Xtriker/Modular_Board/Documentation/Curva de calibracion pasos vs milimetros.ods

Pulley teeth | Belt spech [mm] | Motor angle [°] | Driver microstepping | Motor complete angle | Step per millimeter
30 | 2 | 1.8 | 1 | 200.00 | 3.3
30 | 2 | 1.8 | 2 | 200.00 | 6.7
30 | 2 | 1.8 | 4 | 200.00 | 13.3
30 | 2 | 1.8 | 16 | 200.00 | 53.3
Step per millimeter | Millimeter [mm] | Pulsos a dar
3.3 | 1 | 3
6.6 | 2 | 7
9.9 | 3 | 10
13.2 | 4 | 13
16.5 | 5 | 17
19.8 | 6 | 20
23.1 | 7 | 23
26.4 | 8 | 26
29.7 | 9 | 30
33 | 10 | 33
36.3 | 11 | 36
39.6 | 12 | 40
42.9 | 13 | 43
46.2 | 14 | 46
49.5 | 15 | 50
52.8 | 16 | 53
56.1 | 17 | 56
59.4 | 18 | 59
62.7 | 19 | 63
66 | 20 | 66
69.3 | 21 | 69
72.6 | 22 | 73
75.9 | 23 | 76
79.2 | 24 | 79
82.5 | 25 | 83
85.8 | 26 | 86
89.1 | 27 | 89
92.4 | 28 | 92
95.7 | 29 | 96
99 | 30 | 99
102.3 | 31 | 102
105.6 | 32 | 106
108.9 | 33 | 109
112.2 | 34 | 112
115.5 | 35 | 116
118.8 | 36 | 119
122.1 | 37 | 122
125.4 | 38 | 125
128.7 | 39 | 129
132 | 40 | 132
135.3 | 41 | 135
138.6 | 42 | 139
141.9 | 43 | 142
145.2 | 44 | 145
148.5 | 45 | 149
151.8 | 46 | 152
155.1 | 47 | 155
158.4 | 48 | 158
161.7 | 49 | 162
165 | 50 | 165
168.3 | 51 | 168
171.6 | 52 | 172
174.9 | 53 | 175
178.2 | 54 | 178
181.5 | 55 | 182
184.8 | 56 | 185
188.1 | 57 | 188
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
