Xtriker/Modular_Board/Documentation/Curva_de_calibracion_mm_por_paso.ods

Pulsos | Distancia (cm) | Tiempo (ms) | Frecuencia (Hz) | Microstepping
70 | 1 | 500 | 2 | Full
140 | 2.3 | 500 | 2 | Full
 | 3 | 500 | 2 | Full
 | 4 | 500 | 2 | Full
 | 5 | 500 | 2 | Full
