Xtriker/Modular_Board/EAGLE/projects/Xtriker_Laser_v2/Xtriker_Laser_v2.brd

## EAGLE design EAGLE/projects/Xtriker_Laser_v2/Xtriker_Laser_v2.brd (2020-05-10)

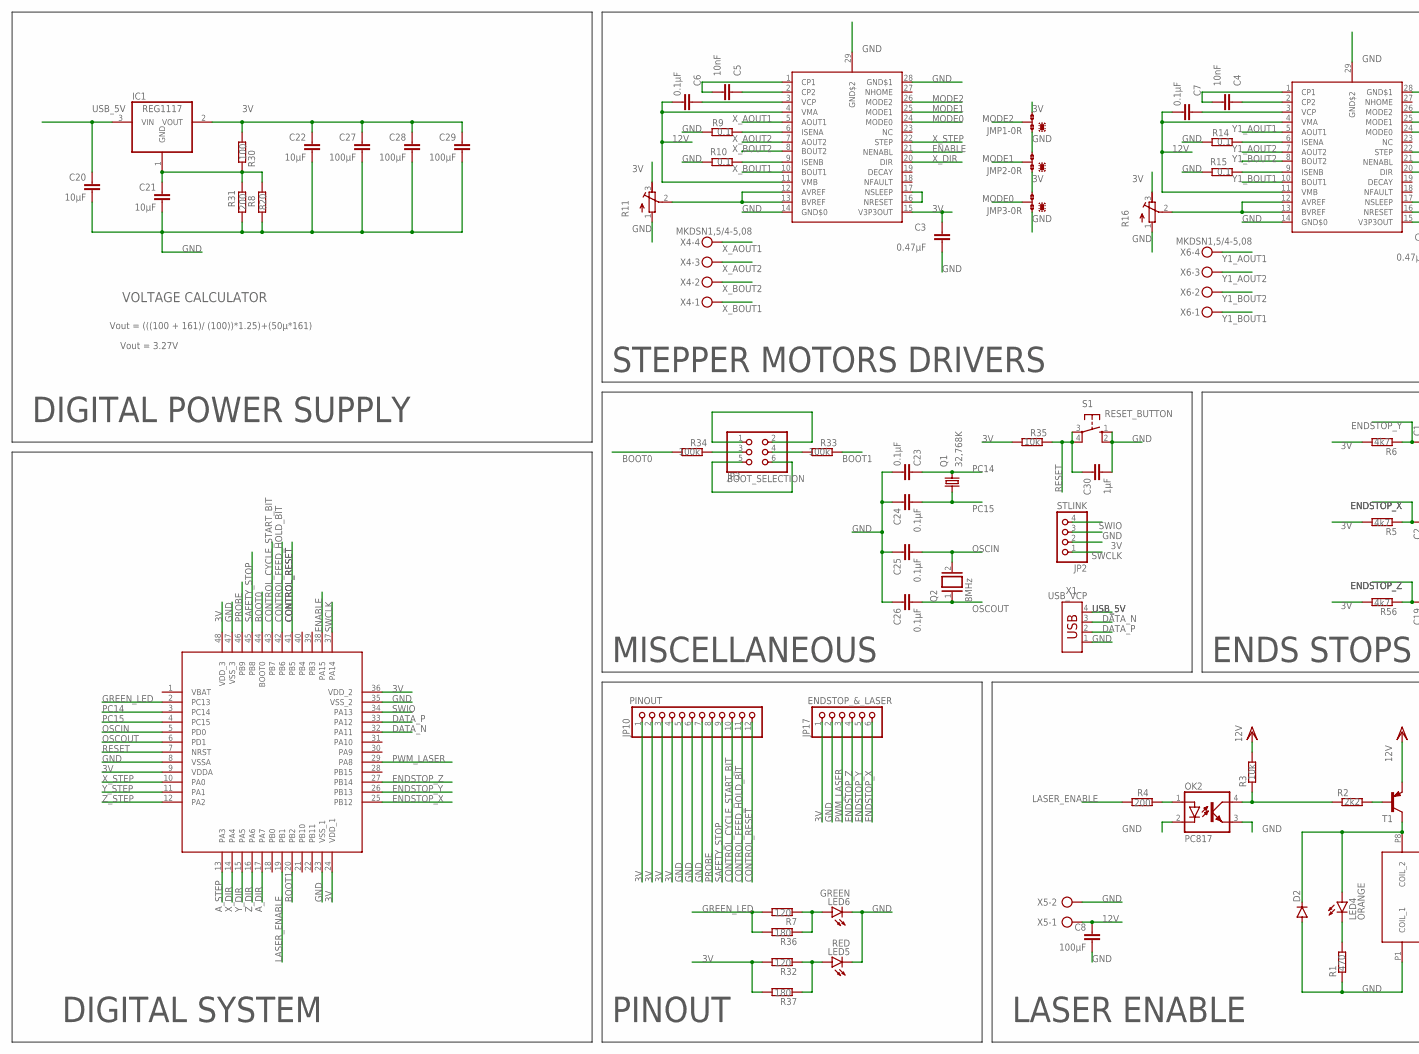
[picture p16: schematic Xtriker_Laser_v2.sch, part in row 1, column 1]

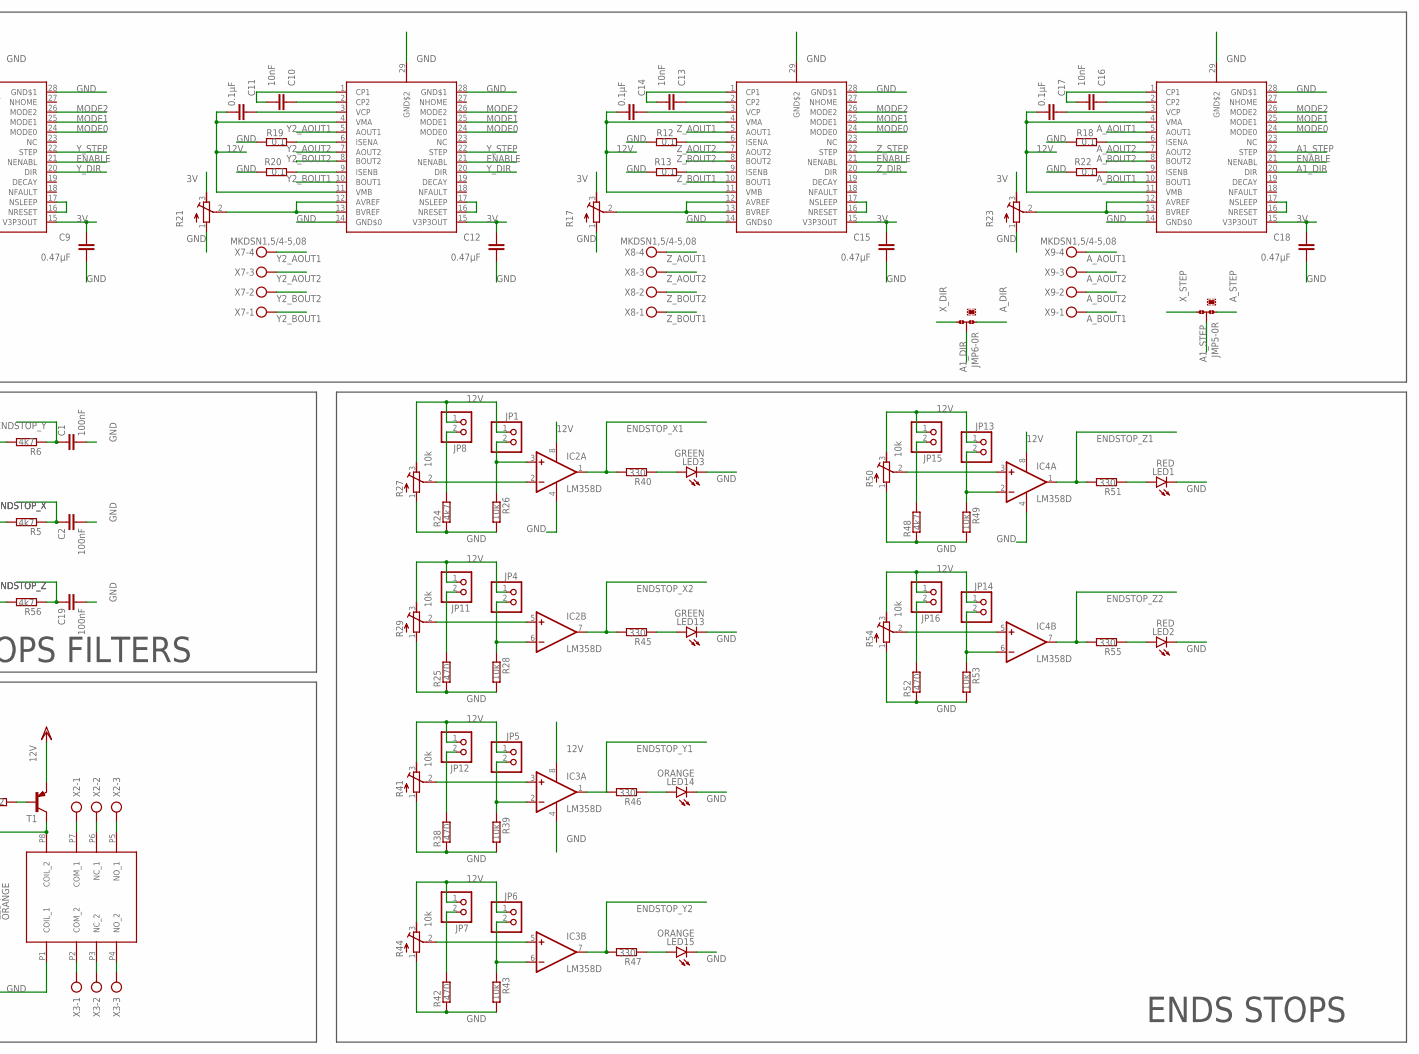
[picture p17: schematic Xtriker_Laser_v2.sch, part in row 1, column 2]

Parts:
C1, C2, C19: 100nF; C0805
C3, C9, C12, C15, C18: 0.47µF; C0805
C4, C5, C10, C13, C16: 10nF; C0805
C6, C7, C11, C14, C17, C23, C24, C25, C26: 0.1µF; C0805
C8, C27, C28, C29: 100µF; C0805
C20, C21, C22: 10µF; C0805
C30: 1µF; C0805
D2: DIODE-DO214AA; DO214AA
IC1: REG1117; SOT223
IC2, IC3, IC4: LM358D; SO08
JMP1, JMP2, JMP3, JMP5, JMP6: 0R-JUMPA; A0R-JMP
JP1, JP4, JP5, JP6, JP7, JP8, JP11, JP12, JP13, JP14, JP15, JP16: PINHD-1X2; 1X02
JP2: STLINK; 1X04
JP3: BOOT_SELECTION; 2X03
JP10: PINOUT; 1X12
JP17: ENDSTOP_&_LASER; 1X06
LED1, LED2, LED5: RED; CHIP-LED0805
LED3, LED6, LED13: GREEN; CHIP-LED0805
LED4, LED14, LED15: ORANGE; CHIP-LED0805
OK2: PC817; DIL04
Q1: 32,768K; 8.2X3.8
Q2: 8MHz; QS
R1, R25, R38, R42, R52: 470; R0805
R2: 2k2; R0805
R3, R26, R28, R35, R39, R43, R49, R53: 10k; R0805
R4, R31: 200; R0805
R5, R6, R24, R48, R56: 4k7; R0805
R7, R32: 120; R0805
R8: 820; R0805
R9, R10, R12, R13, R14, R15, R18, R19, R20, R22: 0.1; R2512
R11, R16, R17, R21, R23: R-TRIMM3296W; RTRIM3296W
R27, R29, R41, R44, R50, R54: 10k; RTRIM3296W
R30: 100; R0805
R33, R34: 100k; R0805
R36, R37: 180; R0805
R40, R45, R46, R47, R51, R55: 330; R0805
S1: RESET_BUTTON; B3F-10XX
T1: -PNP-SOT23-BCE; SOT23-BCE
U$1, U$2, U$3, U$4, U$7: DRV8825; SOP65P660X135-29T310X518N
U$5: TDS-1202L; TDS_1202L
U$6: STM32F103C8_LQFP48; QFP50P900X900X160-48N
X1: USB_VCP; USB
X2, X3: AK500/3
X4, X6, X7, X8, X9: MKDSN1,5/4-5,08
X5: AK500/2

Connections:
3V: C3.1, C9.1, C12.1, C15.1, C18.1, C22.1, C27.1, C28.1, C29.1, IC1.2 (VOUT), JMP1.3, JMP2.1, JMP3.3, JP2.2, JP10.1, JP10.2, JP10.3, JP10.4, JP17.1, R5.2, R6.2, R11.3 (E), R16.3 (E), R17.3 (E), R21.3 (E), R23.3 (E), R30.2, R32.2, R35.2, R37.2, R56.2, U$1.15 (V3P3OUT), U$2.15 (V3P3OUT), U$3.15 (V3P3OUT), U$4.15 (V3P3OUT), U$6.9 (VDDA), U$6.24 (VDD_1), U$6.36 (VDD_2), U$6.48 (VDD_3), U$7.15 (V3P3OUT)
12V: C6.2, C7.2, C8.1, C11.2, C14.2, C17.2, IC2.8 (V+), IC3.8 (V+), IC4.8 (V+), JP1.1, JP4.1, JP5.1, JP6.1, JP7.1, JP8.1, JP11.1, JP12.1, JP13.1, JP14.1, JP15.1, JP16.1, R27.3 (E), R29.3 (E), R41.3 (E), R44.3 (E), R50.3 (E), R54.3 (E), U$1.4 (VMA), U$1.11 (VMB), U$2.4 (VMA), U$2.11 (VMB), U$3.4 (VMA), U$3.11 (VMB), U$4.4 (VMA), U$4.11 (VMB), U$7.4 (VMA), U$7.11 (VMB), X5.1
A1_DIR: JMP6.2, U$7.20 (DIR)
A1_STEP: JMP5.2, U$7.22 (STEP)
A_AOUT1: U$7.5 (AOUT1), X9.4
A_AOUT2: U$7.7 (AOUT2), X9.3
A_BOUT1: U$7.10 (BOUT1), X9.1
A_BOUT2: U$7.8 (BOUT2), X9.2
A_DIR: JMP6.1, U$6.17 (PA7)
A_STEP: JMP5.1, U$6.13 (PA3)
BOOT0: R34.2, U$6.44 (BOOT0)
BOOT1: R33.1, U$6.20 (PB2)
CONTROL_CYCLE_START_BIT: JP10.10, U$6.43 (PB7)
CONTROL_FEED_HOLD_BIT: JP10.11, U$6.42 (PB6)
CONTROL_RESET: JP10.12, U$6.41 (PB5)
DATA_N: U$6.32 (PA11), X1.3
DATA_P: U$6.33 (PA12), X1.2
ENABLE: U$1.21 (NENABL), U$2.21 (NENABL), U$3.21 (NENABL), U$4.21 (NENABL), U$6.38 (PA15), U$7.21 (NENABL)
ENDSTOP_X: C2.1, JP17.6, R5.1, U$6.25 (PB12)
ENDSTOP_X1: IC2.1 (OUT), R40.2
ENDSTOP_X2: IC2.7 (OUT), R45.2
ENDSTOP_Y: C1.1, JP17.5, R6.1, U$6.26 (PB13)
ENDSTOP_Y1: IC3.1 (OUT), R46.2
ENDSTOP_Y2: IC3.7 (OUT), R47.2
ENDSTOP_Z: C19.1, JP17.4, R56.1, U$6.27 (PB14)
ENDSTOP_Z1: IC4.1 (OUT), R51.2
ENDSTOP_Z2: IC4.7 (OUT), R55.2
GND: C1.2, C2.2, C3.2, C8.2, C9.2, C12.2, C15.2, C18.2, C19.2, C20.2, C21.2, C22.2, C23.2, C24.1, C25.1, C26.1, C27.2, C28.2, C29.2, C30.2, D2.A, IC2.4 (V-), IC3.4 (V-), IC4.4 (V-), JMP1.1, JMP2.3, JMP3.1, JP2.3, JP10.5, JP10.6, JP10.7, JP17.2, LED1.C, LED2.C, LED3.C, LED5.C, LED6.C, LED13.C, LED14.C, LED15.C, OK2.2 (C), OK2.3 (EMIT), R1.1, R8.1, R9.1, R10.1, R11.1 (A), R12.1, R13.1, R14.1, R15.1, R16.1 (A), R17.1 (A), R18.1, R19.1, R20.1, R21.1 (A), R22.1, R23.1 (A), R24.1, R25.1, R26.2, R27.1 (A), R28.2, R29.1 (A), R31.1, R38.1, R39.2, R41.1 (A), R42.1, R43.2, R44.1 (A), R48.1, R49.2, R50.1 (A), R52.1, R53.2, R54.1 (A), S1.1 (S), S1.2 (S1), U$1.14 (GND$0), U$1.28 (GND$1), U$1.29 (GND$2), U$2.14 (GND$0), U$2.28 (GND$1), U$2.29 (GND$2), U$3.14 (GND$0), U$3.28 (GND$1), U$3.29 (GND$2), U$4.14 (GND$0), U$4.28 (GND$1), U$4.29 (GND$2), U$5.P1 (COIL_1), U$6.8 (VSSA), U$6.23 (VSS_1), U$6.35 (VSS_2), U$6.47 (VSS_3), U$7.14 (GND$0), U$7.28 (GND$1), U$7.29 (GND$2), X1.1, X5.2
GREEN_LED: R7.2, R36.2, U$6.2 (PC13)
LASER_ENABLE: R4.1, U$6.19 (PB1)
MODE0: JMP3.2, U$1.24 (MODE0), U$2.24 (MODE0), U$3.24 (MODE0), U$4.24 (MODE0), U$7.24 (MODE0)
MODE1: JMP2.2, U$1.25 (MODE1), U$2.25 (MODE1), U$3.25 (MODE1), U$4.25 (MODE1), U$7.25 (MODE1)
MODE2: JMP1.2, U$1.26 (MODE2), U$2.26 (MODE2), U$3.26 (MODE2), U$4.26 (MODE2), U$7.26 (MODE2)
unnamed: C13.2, U$4.1 (CP1)
unnamed: U$1.16 (NRESET), U$1.17 (NSLEEP)
unnamed: C4.2, U$2.1 (CP1)
unnamed: C4.1, U$2.2 (CP2)
unnamed: C7.1, U$2.3 (VCP)
unnamed: R14.2, U$2.6 (ISENA)
unnamed: R15.2, U$2.9 (ISENB)
unnamed: R16.2 (S), U$2.12 (AVREF), U$2.13 (BVREF)
unnamed: C21.1, IC1.1 (GND), R8.2, R30.1, R31.2
unnamed: LED5.A, R32.1, R37.1
unnamed: JP3.1, JP3.2
unnamed: C13.1, U$4.2 (CP2)
unnamed: D2.C, LED4.A, T1.C, U$5.P8 (COIL_2)
unnamed: LED4.C, R1.2
unnamed: R2.2, T1.B
unnamed: OK2.4 (COL), R2.1, R3.1
unnamed: OK2.1 (A), R4.2
unnamed: U$2.16 (NRESET), U$2.17 (NSLEEP)
unnamed: C10.2, U$3.1 (CP1)
unnamed: C10.1, U$3.2 (CP2)
unnamed: C11.1, U$3.3 (VCP)
unnamed: C5.2, U$1.1 (CP1)
unnamed: C5.1, U$1.2 (CP2)
unnamed: C6.1, U$1.3 (VCP)
unnamed: R19.2, U$3.6 (ISENA)
unnamed: R20.2, U$3.9 (ISENB)
unnamed: R9.2, U$1.6 (ISENA)
unnamed: R21.2 (S), U$3.12 (AVREF), U$3.13 (BVREF)
unnamed: U$5.P7 (COM_1), X2.1
unnamed: U$5.P6 (NC_1), X2.2
unnamed: U$5.P5 (NO_1), X2.3
unnamed: U$5.P4 (NO_2), X3.3
unnamed: U$5.P3 (NC_2), X3.2
unnamed: U$5.P2 (COM_2), X3.1
unnamed: LED6.A, R7.1, R36.1
unnamed: C14.1, U$4.3 (VCP)
unnamed: R10.2, U$1.9 (ISENB)
unnamed: U$3.16 (NRESET), U$3.17 (NSLEEP)
unnamed: LED3.A, R40.1
unnamed: IC2.3 (+IN), JP1.2, R26.1
unnamed: JP3.5, JP3.6
unnamed: JP3.3, R34.1
unnamed: JP3.4, R33.2
unnamed: R11.2 (S), U$1.12 (AVREF), U$1.13 (BVREF)
unnamed: JP8.2, R24.2
unnamed: IC2.6 (-IN), JP4.2, R28.1
unnamed: IC2.2 (-IN), R27.2 (S)
unnamed: JP11.2, R25.2
unnamed: IC2.5 (+IN), R29.2 (S)
unnamed: IC3.2 (-IN), JP5.2, R39.1
unnamed: JP12.2, R38.2
unnamed: IC3.3 (+IN), R41.2 (S)
unnamed: IC3.6 (-IN), JP6.2, R43.1
unnamed: JP7.2, R42.2
unnamed: IC3.5 (+IN), R44.2 (S)
unnamed: LED13.A, R45.1
unnamed: LED14.A, R46.1
unnamed: LED15.A, R47.1
unnamed: R12.2, U$4.6 (ISENA)
unnamed: R13.2, U$4.9 (ISENB)
unnamed: R17.2 (S), U$4.12 (AVREF), U$4.13 (BVREF)
unnamed: U$4.16 (NRESET), U$4.17 (NSLEEP)
unnamed: C16.2, U$7.1 (CP1)
unnamed: C16.1, U$7.2 (CP2)
unnamed: C17.1, U$7.3 (VCP)
unnamed: R18.2, U$7.6 (ISENA)
unnamed: R22.2, U$7.9 (ISENB)
unnamed: R23.2 (S), U$7.12 (AVREF), U$7.13 (BVREF)
unnamed: U$7.16 (NRESET), U$7.17 (NSLEEP)
unnamed: IC4.2 (-IN), JP13.2, R49.1
unnamed: JP15.2, R48.2
unnamed: IC4.3 (+IN), R50.2 (S)
unnamed: LED1.A, R51.1
unnamed: IC4.6 (-IN), JP14.2, R53.1
unnamed: JP16.2, R52.2
unnamed: IC4.5 (+IN), R54.2 (S)
unnamed: LED2.A, R55.1
OSCIN: C25.2, Q2.2, U$6.5 (PD0)
OSCOUT: C26.2, Q2.1, U$6.6 (PD1)
PC14: C23.1, Q1.4 (2), U$6.3 (PC14)
PC15: C24.2, Q1.1, U$6.4 (PC15)
PROBE: JP10.8, U$6.46 (PB9)
PWM_LASER: JP17.3, U$6.29 (PA8)
RESET: C30.1, R35.1, S1.3, S1.4 (P1), U$6.7 (NRST)
SAFETY_STOP: JP10.9, U$6.45 (PB8)
SWCLK: JP2.1, U$6.37 (PA14)
SWIO: JP2.4, U$6.34 (PA13)
USB_5V: C20.1, IC1.3 (VIN), X1.4
VDD: R3.2, T1.E
X_AOUT1: U$1.5 (AOUT1), X4.4
X_AOUT2: U$1.7 (AOUT2), X4.3
X_BOUT1: U$1.10 (BOUT1), X4.1
X_BOUT2: U$1.8 (BOUT2), X4.2
X_DIR: JMP6.3, U$1.20 (DIR), U$6.14 (PA4)
X_STEP: JMP5.3, U$1.22 (STEP), U$6.10 (PA0)
Y1_AOUT1: U$2.5 (AOUT1), X6.4
Y1_AOUT2: U$2.7 (AOUT2), X6.3
Y1_BOUT1: U$2.10 (BOUT1), X6.1
Y1_BOUT2: U$2.8 (BOUT2), X6.2
Y2_AOUT1: U$3.5 (AOUT1), X7.4
Y2_AOUT2: U$3.7 (AOUT2), X7.3
Y2_BOUT1: U$3.10 (BOUT1), X7.1
Y2_BOUT2: U$3.8 (BOUT2), X7.2
Y_DIR: U$2.20 (DIR), U$3.20 (DIR), U$6.15 (PA5)
Y_STEP: U$2.22 (STEP), U$3.22 (STEP), U$6.11 (PA1)
Z_AOUT1: U$4.5 (AOUT1), X8.4
Z_AOUT2: U$4.7 (AOUT2), X8.3
Z_BOUT1: U$4.10 (BOUT1), X8.1
Z_BOUT2: U$4.8 (BOUT2), X8.2
Z_DIR: U$4.20 (DIR), U$6.16 (PA6)
Z_STEP: U$4.22 (STEP), U$6.12 (PA2)

Notes on the sheet:
ENDS STOPS FILTERS
MISCELLANEOUS
LASER ENABLE
STEPPER MOTORS DRIVERS
PINOUT
DIGITAL POWER SUPPLY
DIGITAL SYSTEM
Vout = (((100 + 161)/ (100))*1.25)+(50µ*161)
Vout = 3.27V
VOLTAGE CALCULATOR
ENDS STOPS

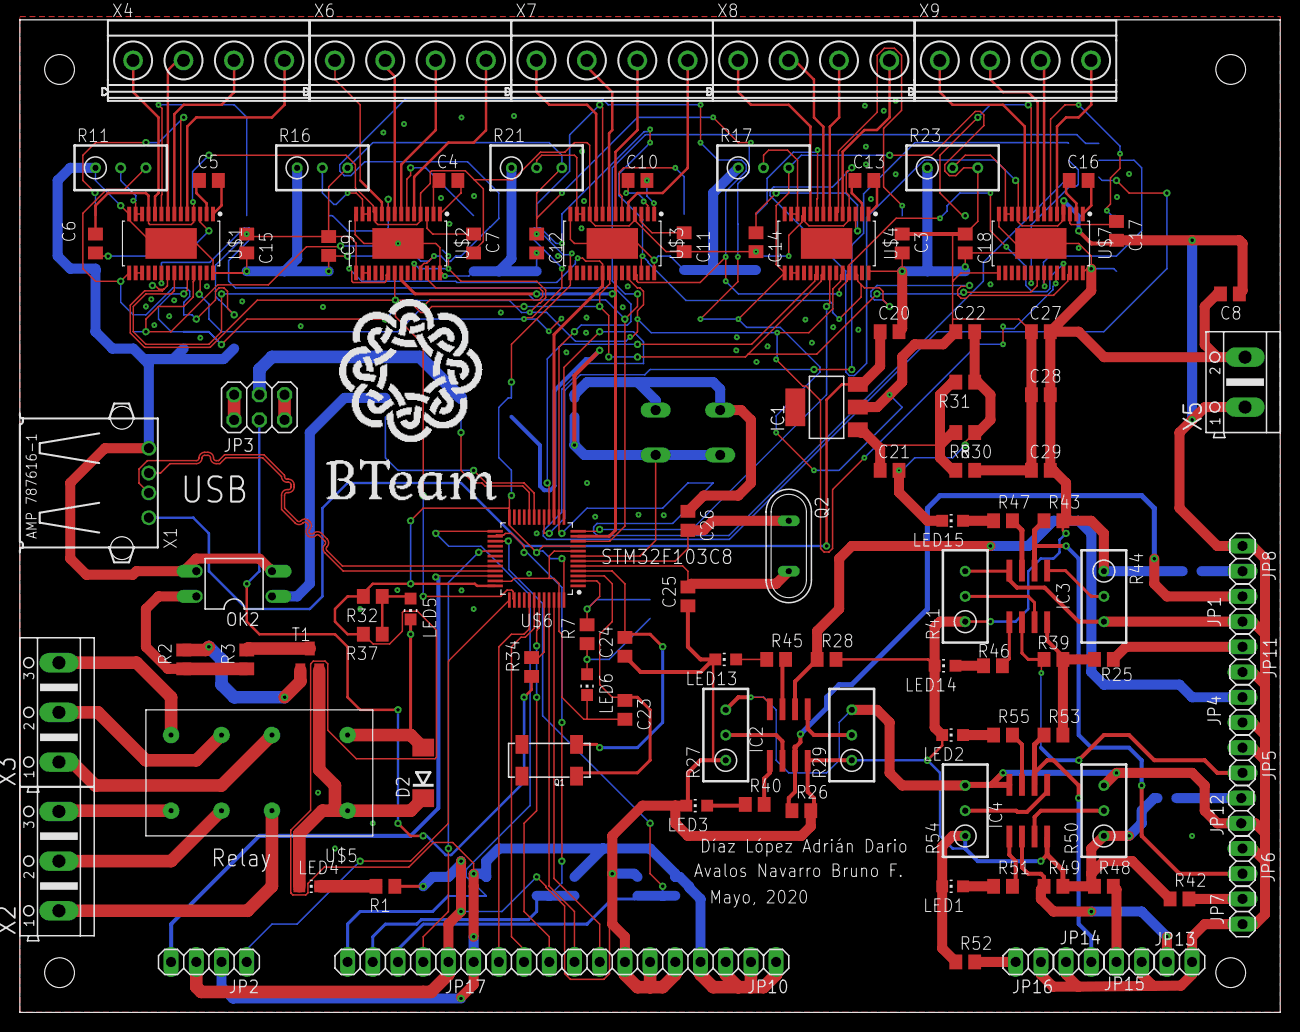
[picture p18: board Xtriker_Laser_v2.brd from above]

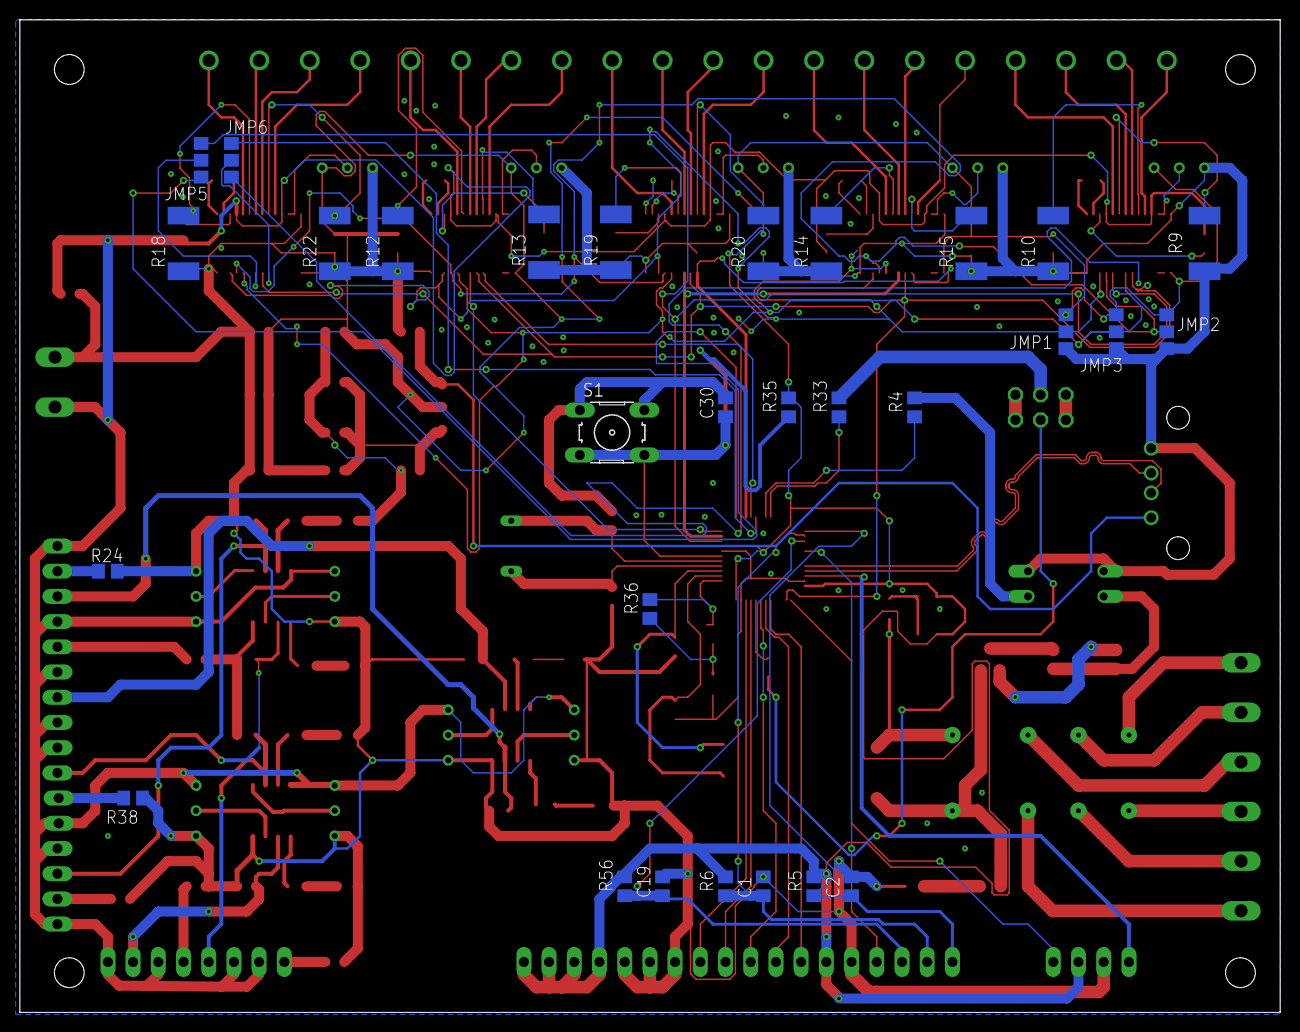
[picture p19: board Xtriker_Laser_v2.brd from below]

Board: 2 copper layers, 127.0 x 100.0 mm, 142 parts (29 on the bottom side), 144 nets.
