Xtriker/Modular_Board/EAGLE/projects/Xtriker_Laser_v1/Xtriker_Laser.brd

## EAGLE design EAGLE/projects/Xtriker_Laser_v1/Xtriker_Laser.brd (2020-04-30, an earlier design)

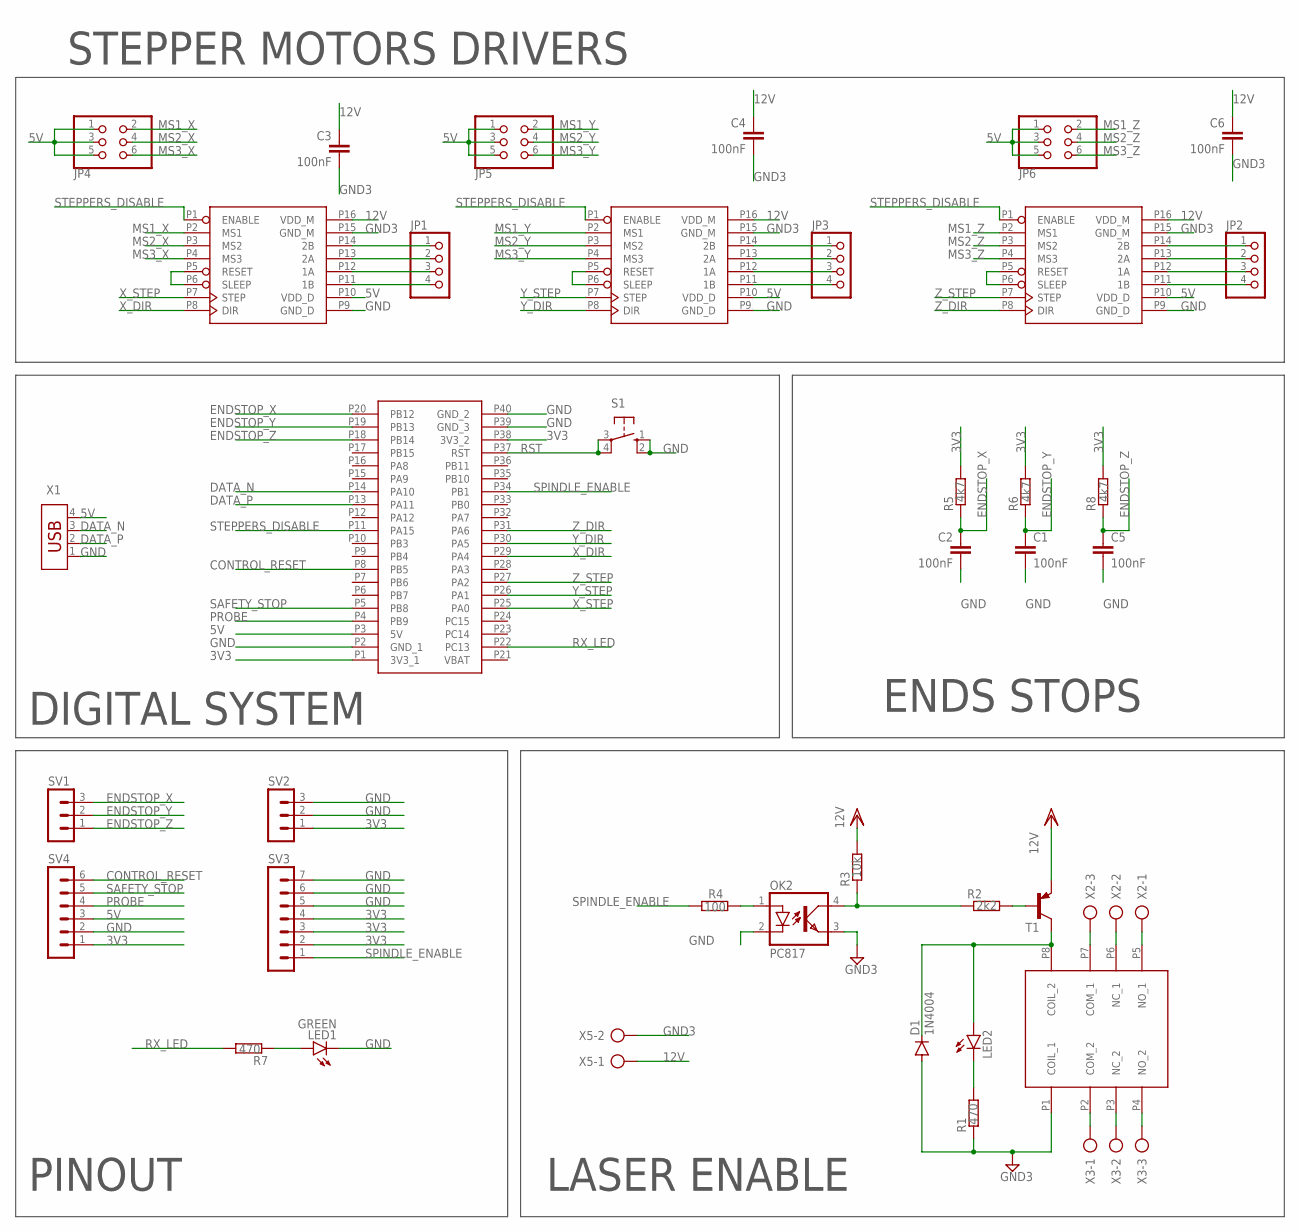
[picture p20: schematic Xtriker_Laser.sch]

Parts:
C1, C2, C3, C4, C5, C6: 100nF; C0805
D1: 1N4004; DO41-10
JP1, JP2, JP3: PINHD-1X4; 1X04
JP4, JP5, JP6: PINHD-2X3; 2X03
LED1: GREEN; LED3MM
LED2: LED3MM
OK2: PC817; DIL04
R1, R7: 470; R0805
R2: 2k2; R0805
R3: 10k; R0805
R4: 100; R0805
R5, R6, R8: 4k7; R0805
S1: 10-XX; B3F-10XX
SV1, SV2: MA03-1
SV3: MA07-1
SV4: MA06-1
T1: -PNP-SOT23-BCE; SOT23-BCE
U$1, U$2, U$3: A4988
U$4: BLUEPILL_STM32F103C8
U$5: TDS-1202L; TDS_1202L
X1: USB-787616; USB
X2, X3: AK500/3
X5: AK500/2

Connections:
3V3: R5.2, R6.2, R8.2, SV2.1, SV3.2, SV3.3, SV3.4, SV4.1, U$4.P1 (3V3_1), U$4.P38 (3V3_2)
5V: JP4.1, JP4.3, JP4.5, JP5.1, JP5.3, JP5.5, JP6.1, JP6.3, JP6.5, SV4.3, U$1.P10 (VDD_D), U$2.P10 (VDD_D), U$3.P10 (VDD_D), U$4.P3 (5V), X1.4
12V: C3.1, C4.1, C6.1, U$1.P16 (VDD_M), U$2.P16 (VDD_M), U$3.P16 (VDD_M), X5.1
CONTROL_RESET: SV4.6, U$4.P8 (PB5)
DATA_N: U$4.P14 (PA10), X1.3
DATA_P: U$4.P13 (PA11), X1.2
ENDSTOP_X: C2.1, R5.1, SV1.3, U$4.P20 (PB12)
ENDSTOP_Y: C1.1, R6.1, SV1.2, U$4.P19 (PB13)
ENDSTOP_Z: C5.1, R8.1, SV1.1, U$4.P18 (PB14)
GND: C1.2, C2.2, C5.2, LED1.K (C), OK2.2 (C), S1.1 (S), S1.2 (S1), SV2.2, SV2.3, SV3.5, SV3.6, SV3.7, SV4.2, U$1.P9 (GND_D), U$2.P9 (GND_D), U$3.P9 (GND_D), U$4.P2 (GND_1), U$4.P39 (GND_3), U$4.P40 (GND_2), X1.1
GND3: C3.2, C4.2, C6.2, D1.A, OK2.3 (EMIT), R1.1, U$1.P15 (GND_M), U$2.P15 (GND_M), U$3.P15 (GND_M), U$5.P1 (COIL_1), X5.2
MS1_X: JP4.2, U$1.P2 (MS1)
MS1_Y: JP5.2, U$3.P2 (MS1)
MS1_Z: JP6.2, U$2.P2 (MS1)
MS2_X: JP4.4, U$1.P3 (MS2)
MS2_Y: JP5.4, U$3.P3 (MS2)
MS2_Z: JP6.4, U$2.P3 (MS2)
MS3_X: JP4.6, U$1.P4 (MS3)
MS3_Y: JP5.6, U$3.P4 (MS3)
MS3_Z: JP6.6, U$2.P4 (MS3)
unnamed: JP2.4, U$2.P11 (1B)
unnamed: JP2.3, U$2.P12 (1A)
unnamed: JP2.2, U$2.P13 (2A)
unnamed: JP2.1, U$2.P14 (2B)
unnamed: JP3.4, U$3.P11 (1B)
unnamed: JP3.3, U$3.P12 (1A)
unnamed: JP3.2, U$3.P13 (2A)
unnamed: JP3.1, U$3.P14 (2B)
unnamed: JP1.4, U$1.P11 (1B)
unnamed: JP1.3, U$1.P12 (1A)
unnamed: JP1.2, U$1.P13 (2A)
unnamed: D1.C, LED2.A, T1.C, U$5.P8 (COIL_2)
unnamed: LED2.K (C), R1.2
unnamed: R2.2, T1.B
unnamed: OK2.4 (COL), R2.1, R3.1
unnamed: OK2.1 (A), R4.2
unnamed: U$1.P5 (RESET), U$1.P6 (SLEEP)
unnamed: U$3.P5 (RESET), U$3.P6 (SLEEP)
unnamed: U$2.P5 (RESET), U$2.P6 (SLEEP)
unnamed: U$5.P5 (NO_1), X2.1
unnamed: U$5.P6 (NC_1), X2.2
unnamed: U$5.P7 (COM_1), X2.3
unnamed: U$5.P4 (NO_2), X3.3
unnamed: U$5.P3 (NC_2), X3.2
unnamed: U$5.P2 (COM_2), X3.1
unnamed: LED1.A, R7.1
PROBE: SV4.4, U$4.P4 (PB9)
RST: S1.3, S1.4 (P1), U$4.P37 (RST)
RX_LED: R7.2, U$4.P22 (PC13)
SAFETY_STOP: SV4.5, U$4.P5 (PB8)
SMX_2B: JP1.1, U$1.P14 (2B)
SPINDLE_ENABLE: R4.1, SV3.1, U$4.P34 (PB1)
STEPPERS_DISABLE: U$1.P1 (ENABLE), U$2.P1 (ENABLE), U$3.P1 (ENABLE), U$4.P11 (PA15)
VBAT: U$4.P21 (VBAT)
VDD: R3.2, T1.E
X_DIR: U$1.P8 (DIR), U$4.P29 (PA4)
X_STEP: U$1.P7 (STEP), U$4.P25 (PA0)
Y_DIR: U$3.P8 (DIR), U$4.P30 (PA5)
Y_STEP: U$3.P7 (STEP), U$4.P26 (PA1)
Z_DIR: U$2.P8 (DIR), U$4.P31 (PA6)
Z_STEP: U$2.P7 (STEP), U$4.P27 (PA2)

Notes on the sheet:
ENDS STOPS
DIGITAL SYSTEM
LASER ENABLE
STEPPER MOTORS DRIVERS
PINOUT

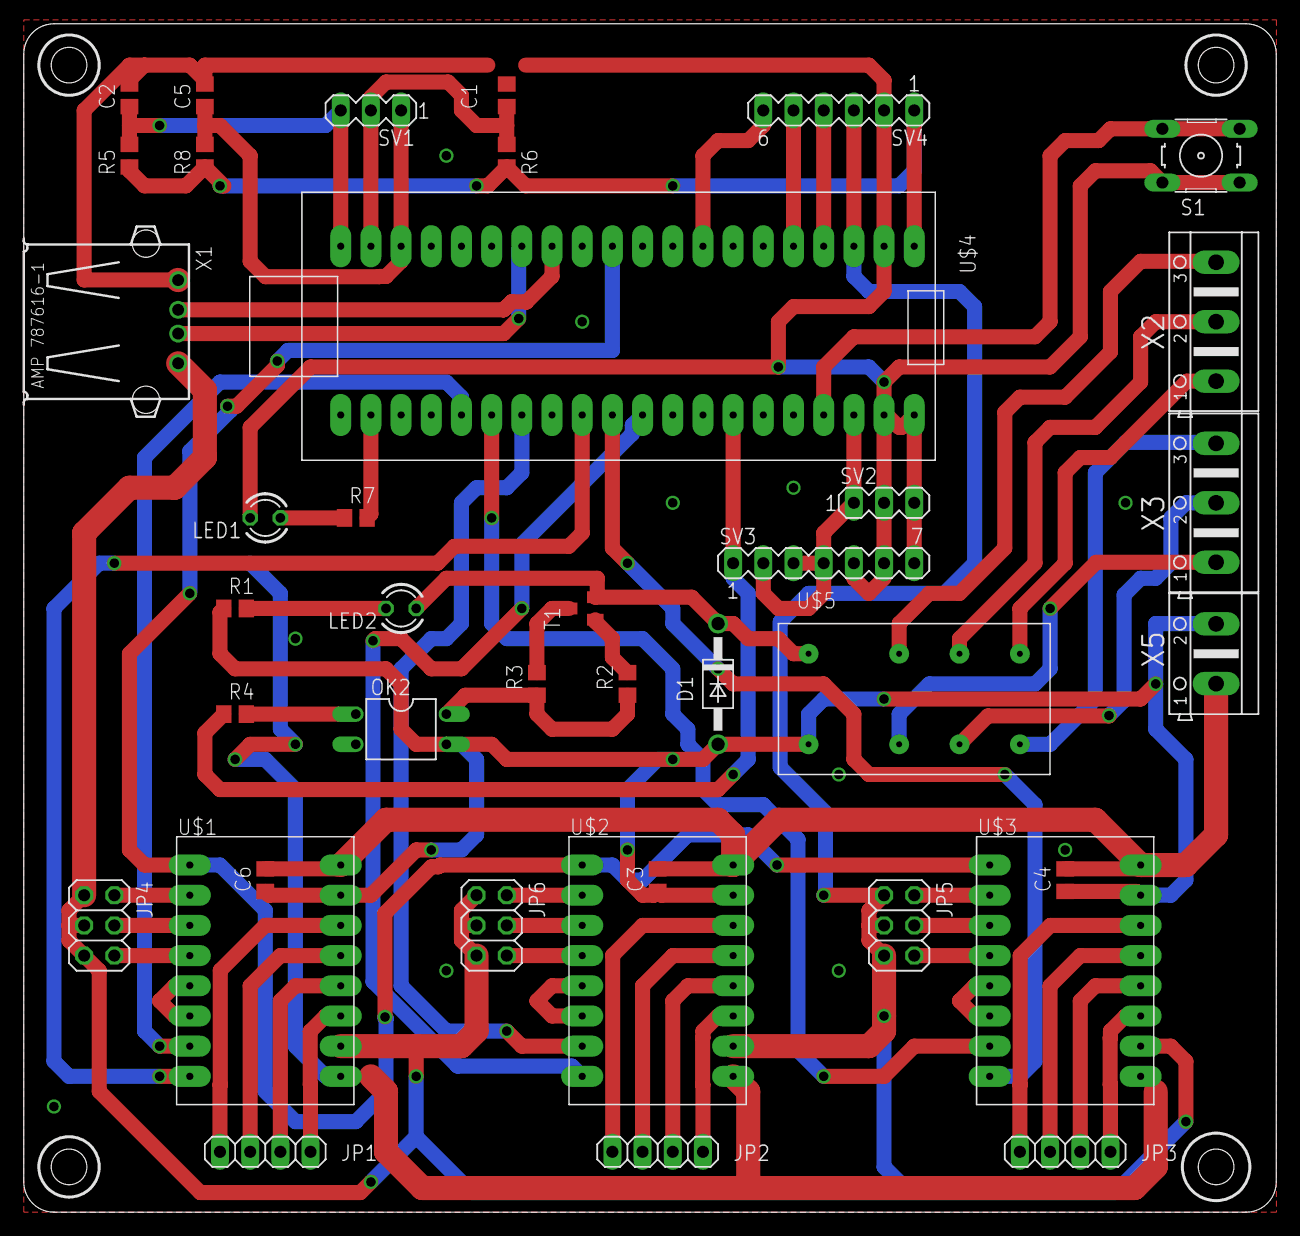
[picture p21: board Xtriker_Laser.brd from above]

Board: 2 copper layers, 105.4 x 100.0 mm, 39 parts (0 on the bottom side), 60 nets.
