Xtriker/Modular_Board/EAGLE/projects/Stepper Driver 3A/Stepper Driver.brd

## EAGLE design EAGLE/projects/Stepper Driver 3A/Stepper Driver.brd (2020-04-30)

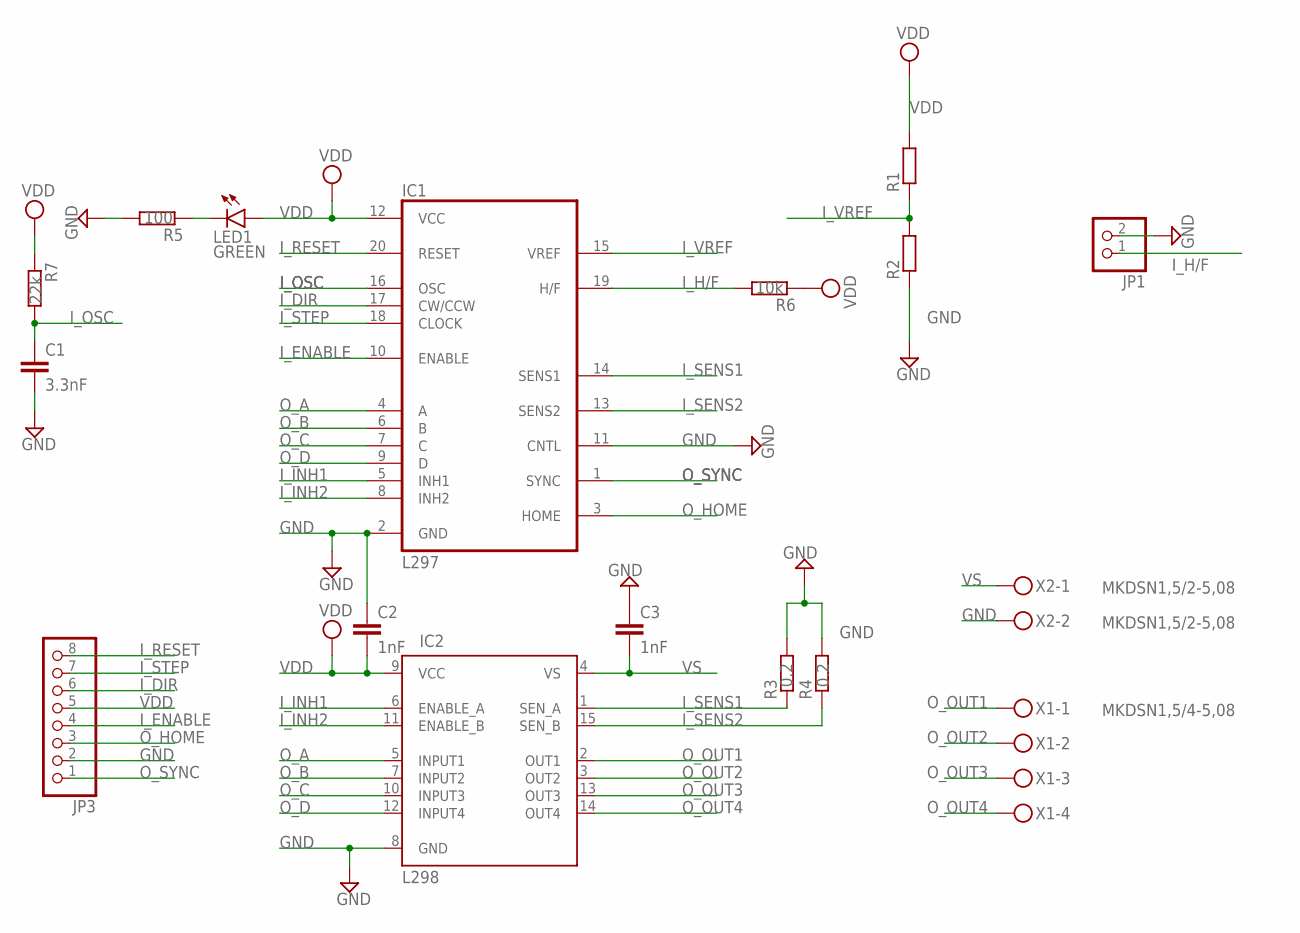
[picture p22: schematic Stepper Driver.sch]

Parts:
C1: 3.3nF; C0805K
C2, C3: 1nF; C0805K
IC1: L297; DIL20
IC2: L298; MULTIWATT-15
JP1: PINHD-1X2; 1X02
JP3: PINHD-1X8; 1X08
LED1: GREEN; LED5MM
R1, R2: R-EU_R0805; R0805
R3, R4: 0.2; R2512
R5: 100; R0805
R6: 10k; R0805
R7: 22k; R0805
X1: MKDSN1,5/4-5,08
X2: MKDSN1,5/2-5,08

Connections:
GND: C1.2, C2.1, C3.1, IC1.2 (GND), IC1.11 (CNTL), IC2.8 (GND), JP1.2, JP3.2, R2.1, R3.2, R4.2, R5.2, X2.2
I_DIR: IC1.17 (CW/CCW), JP3.6
I_ENABLE: IC1.10 (ENABLE), JP3.4
I_H/F: IC1.19 (H/F), JP1.1, R6.2
I_INH1: IC1.5 (INH1), IC2.6 (ENABLE_A)
I_INH2: IC1.8 (INH2), IC2.11 (ENABLE_B)
I_OSC: C1.1, IC1.16 (OSC), R7.2
I_RESET: IC1.20 (RESET), JP3.8
I_SENS1: IC1.14 (SENS1), IC2.1 (SEN_A), R3.1
I_SENS2: IC1.13 (SENS2), IC2.15 (SEN_B), R4.1
I_STEP: IC1.18 (CLOCK), JP3.7
I_VREF: IC1.15 (VREF), R1.1, R2.2
unnamed: LED1.K (C), R5.1
O_A: IC1.4 (A), IC2.5 (INPUT1)
O_B: IC1.6 (B), IC2.7 (INPUT2)
O_C: IC1.7 (C), IC2.10 (INPUT3)
O_D: IC1.9 (D), IC2.12 (INPUT4)
O_HOME: IC1.3 (HOME), JP3.3
O_OUT1: IC2.2 (OUT1), X1.1
O_OUT2: IC2.3 (OUT2), X1.2
O_OUT3: IC2.13 (OUT3), X1.3
O_OUT4: IC2.14 (OUT4), X1.4
O_SYNC: IC1.1 (SYNC), JP3.1
VDD: C2.2, IC1.12 (VCC), IC2.9 (VCC), JP3.5, LED1.A, R1.2, R6.1, R7.1
VS: C3.2, IC2.4 (VS), X2.1

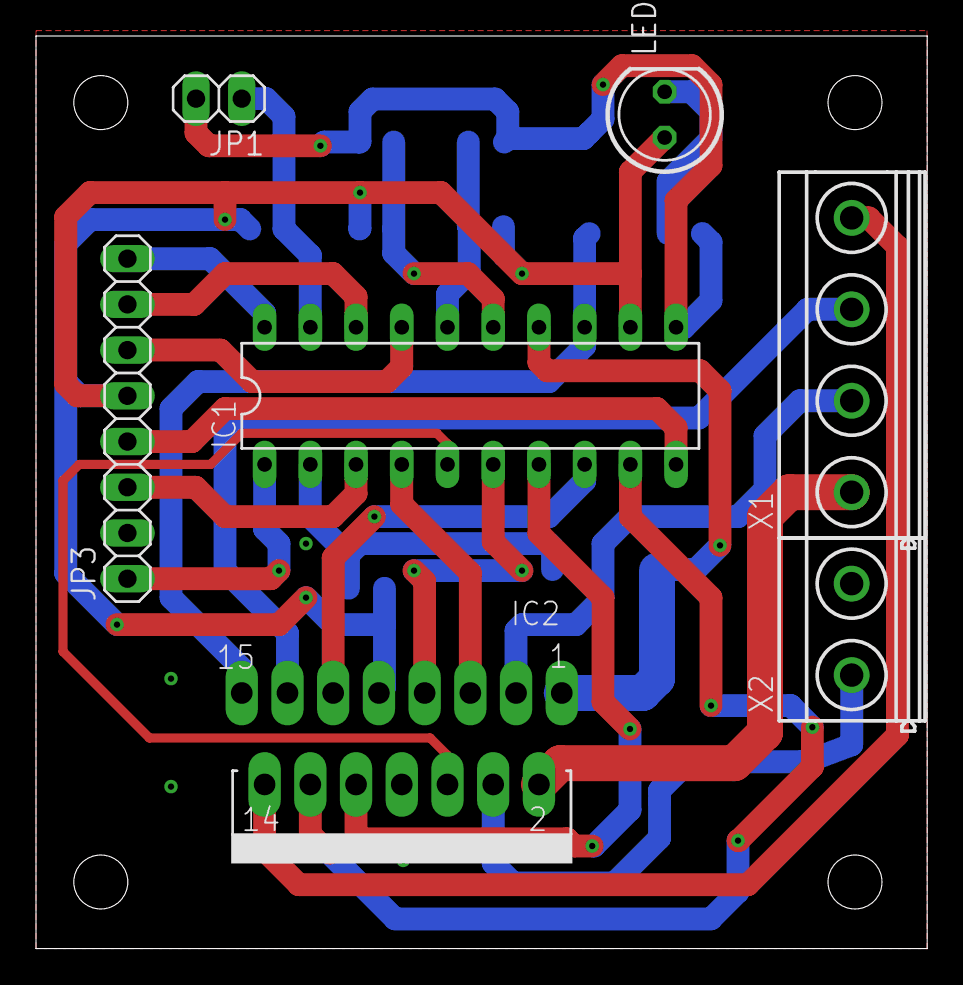
[picture p23: board Stepper Driver.brd from above]

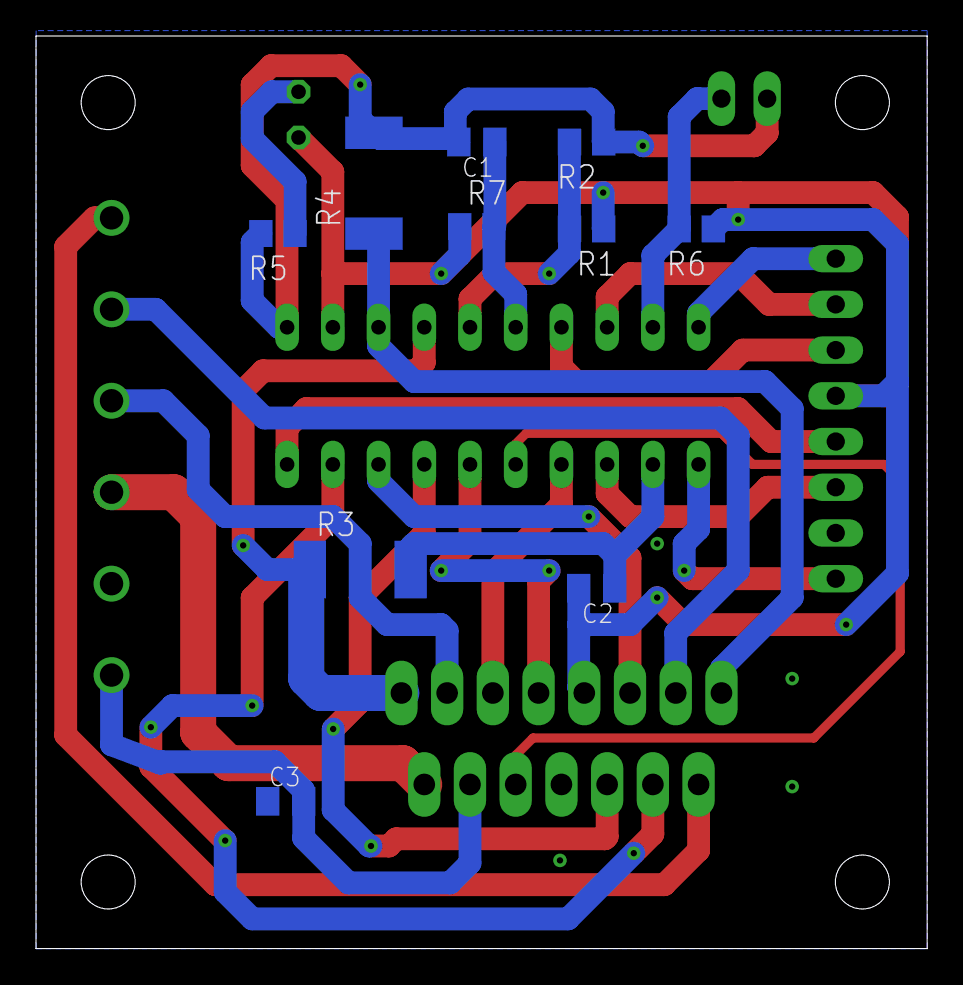
[picture p24: board Stepper Driver.brd from below]

Board: 2 copper layers, 49.5 x 50.7 mm, 17 parts (10 on the bottom side), 25 nets.
