Xtriker/Modular_Board/Code/src/Aplicaciones/Macros.h

/* Definicion de las macros */

/* Estos parametros se determinan mediate el numero de dientes del piñon de los ejes */
/* y la distancia de la correa (Pulley spech) */

/* Teniendo un motor con 1.8 angulo por paso */

#define Steps_rev 200 

/* Si se quieren avanzar 200 pasos eso sera igual a 60 mm por revolucion */

#define mm_rev 60
