Xtriker/Modular_Board/(commit log)

2020-04-30 Anexo de los .brd y los esquematicos
    [ReproductorAudio.sch, Stepper Driver.brd, Stepper Driver.sch, Xtriker_Laser.brd, Xtriker_Laser.sch, Xtriker_Laser_v2.brd, Xtriker_Laser_v2.sch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]
2020-04-30 Cambios en tamaño de las pistas
    [Xtriker_Laser_v2.brd]
2020-04-30 Añadido pistas del Microcontrolador
    [Xtriker_Laser_v2.brd]
2020-05-04 Pre terminado de inserción de pistas
    [Xtriker_Laser_v2.brd]
2020-05-05 Ruteado completo de la PCB
    [Xtriker_Laser_v2.brd]
2020-05-10 Etiquetado y logo
    [Xtriker_Laser_v2.brd]
2020-05-10 Anexo de la plantilla para la documentación
2020-05-10 Documento Generación de archivos Gerber
2020-05-10 Modificación de la documentación
    [Xtriker_Laser_v2.brd]
2020-05-10 Documentación: BOM list & T10
    [Lista BOM.xlsx, Xtriker_Laser_v2.xlsx]
2020-05-10 Descripción de proceso de generación de archivos
2020-05-15 Proyecto Mbed modular
    [mbed-os-base_map.csv]
2020-05-16 Se añade soporte del encoder eje Y
    [mbed-os-base_map.csv]
2020-05-21 Se realiza cambio de Mbed Studio a Visual Studio Code
    [Curva_de_calibracion_PWM_Steps.xlsx, mbed-os-base_map.csv]
2020-05-21 Se agrega documentación de la trjeta
    [Curva_de_calibracion_PWM_Steps.xlsx]
2020-05-22 Modificación y prueba física del movimiento de los motores a pasos
2020-05-22 Curva de calibracion mm vs pasos
    [Curva_de_calibracion_mm_por_paso.ods]
2020-05-24 Eje X&Y y finales de carrera
    Prueba de los ejes X y Y, y los finales de carrera; se sube la documentación sobre la maquina de estados usada, además de la curva de calibración de la distancia de los motores conforme a los parámetros mecánicos.
    [Curva de calibracion pasos vs milimetros.ods]
2020-05-25 Se organiza las librerías en la carpeta Aplicaciones
    Se realiza la inserción de la librería rtos.h para implementarla en un futuro en la tarjeta de desarrollo
2020-05-27 Se usa el segundo final de carrera.
    Se sigue trabajando en Mbed
2020-05-28 Movimiento en paralelo de los motores
2020-05-28 Documentación algoritmo curva de aceleración
2020-05-28 Ecuaciones importantes para el calculo de aceleración lineal
2020-05-28 Ecuaciones para implementar en el microcontrolador
2020-05-29 Se realiza cambio de la ecuación de distancia
    Se hace cambio de la ecuación de distancia en mm de ambos eje, se sube la documentación de la ecuación y esta en espera la implementación del sistema de control de la aceleración.
2020-05-29 Se anexa ecuación de distancia
    Se coloca un archivo .xls donde se realizaron los respectivos cálculos de la maquina para determinar los respectivos pasos por mm.
    [Ecuacion_de_distancia.xlsx]
